Fattoresaimon/i2cencoder/RPi Demo/README.md

# I2C Encoder RPi Demo
--------------------------------------------------------------------------------

## Introduction

Here you can find a sample code written in C for the RPi.
With this code you can read up to 5 boards.
