Fattoresaimon/i2cencoder/Bottom_silk.jpg

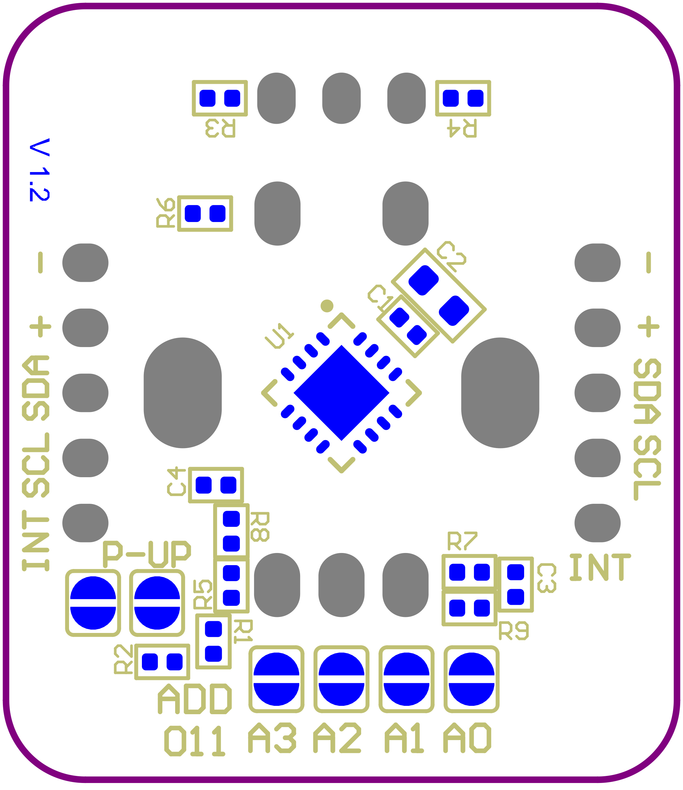
Bottom_silk.jpg
