Fattoresaimon/i2cencoder/ChainExample_Bot.jpg

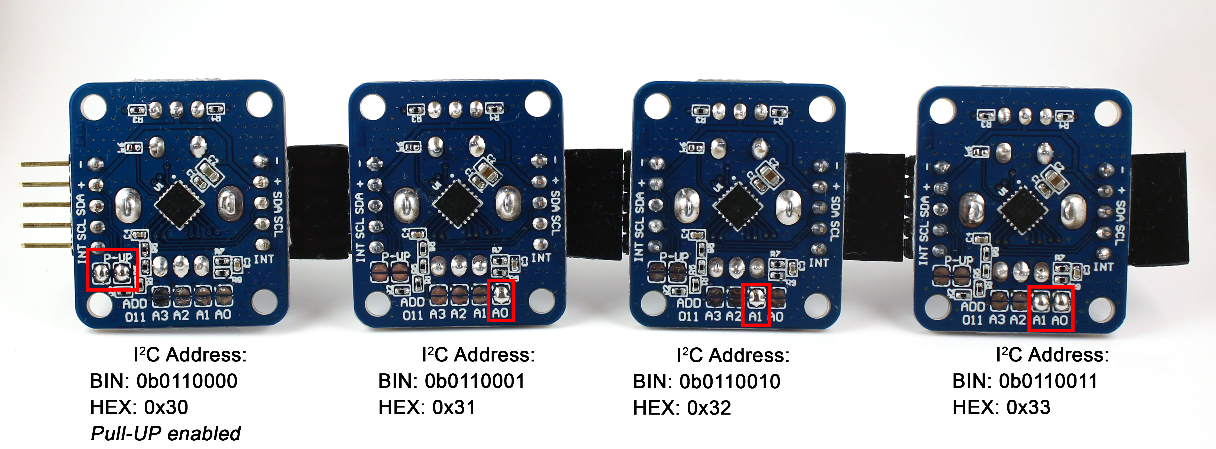
ChainExample_Bot.jpg
