Fattoresaimon/i2cencoder/Dimension.jpg

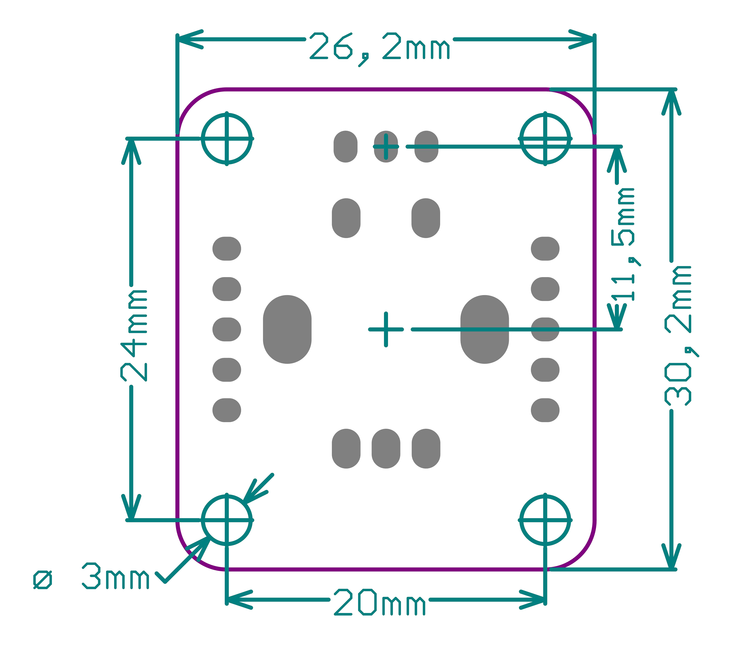
Dimension.jpg
