Fattoresaimon/i2cencoder/I2C Address Setting.PNG

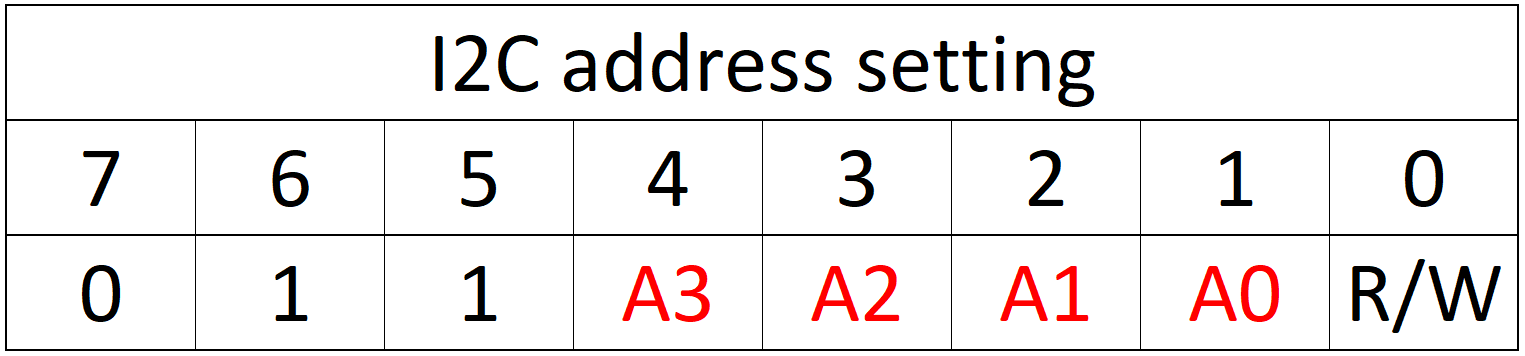
I2C Address Setting.PNG
