Fattoresaimon/i2cencoder/I2C_PullUP_Enable.jpg

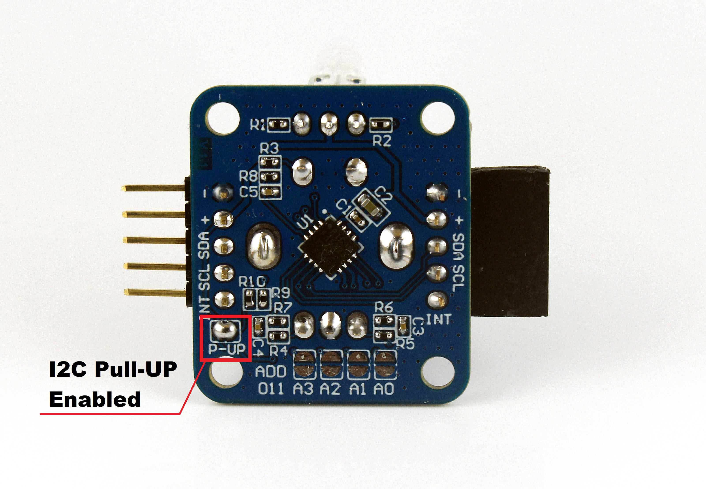
I2C_PullUP_Enable.jpg
