Fattoresaimon/i2cencoder/Pinout.jpg

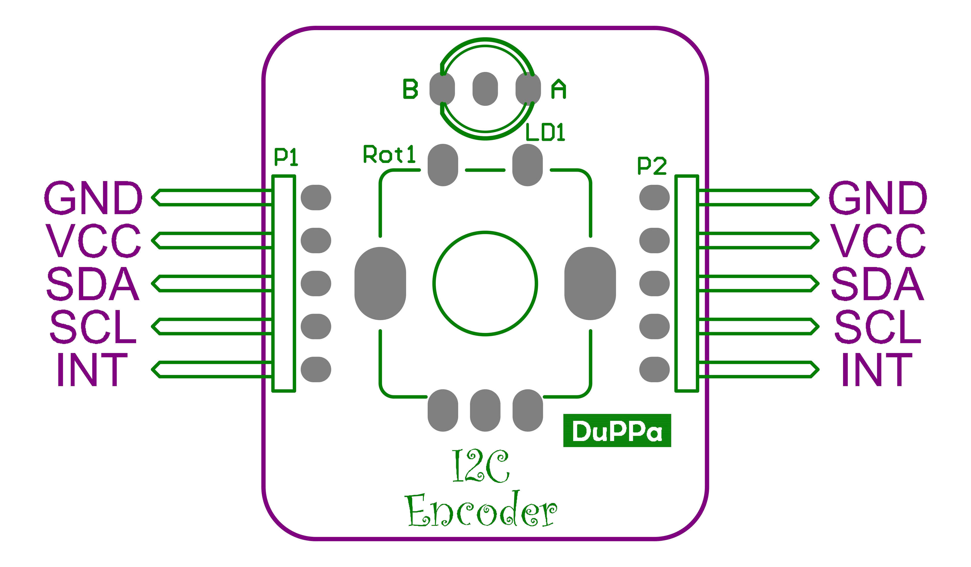
Pinout.jpg
