Fattoresaimon/i2cencoder/Hardware/EncoderI2C.xls

Description | Designator | Value | PartNumber | MouserCode | FarnellCode
Capacitor | C1 | 100n | GRM155R61C104KA88D | 81-GRM155R61C104KA8D
Capacitor | C2 | 4u7 | CC0603KRX5R7BB475 | 603-CC603KRX5R7BB475
Capacitor | C3 | 10n | GRM155R71H103KA88D | 81-GRM155R71H103KA8D
Capacitor | C4 | 10n | GRM155R71H103KA88D | 81-GRM155R71H103KA8D
Common Anode bi-color LED | LD1
Header, 5-Pin, Right Angle Male | P1 |  | 22-28-8050 | 538-22-28-8050
Header, 5-Pin, Right Angle Female | P2 |  | BG302-05-A-L-G |  | 2084275
Resistor | R1 | 4k7 | ERJ-2GEJ4R7X | 667-ERJ-2GEJ4R7X
Resistor | R2 | 4k7 | ERJ-2GEJ4R7X | 667-ERJ-2GEJ4R7X
Resistor | R3 | 110r | ERJ-2GEJ111X | 667-ERJ-2GEJ111X
Resistor | R4 | 110r | ERJ-2GEJ111X | 667-ERJ-2GEJ111X
Resistor | R5 | 10k | RC0402FR-0710KL | 603-RC0402FR-0710KL
Resistor | R6 | 10k | RC0402FR-0710KL | 603-RC0402FR-0710KL
Resistor | R7 | 10k | RC0402FR-0710KL | 603-RC0402FR-0710KL
Resistor | R8 | 10k | RC0402FR-0710KL | 603-RC0402FR-0710KL
Rotary Encoder | Rot1
SMD Jumper | SJ1
SMD Jumper | SJ2
SMD Jumper | SJ3
SMD Jumper | SJ4
SMD Jumper | SJ5
SMD Jumper | SJ6
Flash, 8-Bit Microcontroller, 20 MHz, 11 I/O, -40 to 125 degC, 16-pin QFN (MG16), Tube | U1 |  | PIC16F15323-I/JQ | 579-PIC16F15323-I/JQ
