Fattoresaimon/i2cencoder/(threads)

Thread 2 (2018-07-19):

Encoder button pushed?

MoonMoon82, 2018-07-19:
Hi! I just started working with the i2c rotary encoder.
The first question is: How can I determin if the pushbutton is (still) pressed and released?

Thx and kind regards

MoonMoon82, 2018-07-20:
Thanks for your answer!
I reviewed the schematic and connected a GPIO of my arduino to the pushbutton pin (see picture below).
Now I can use readStatus(E_PUSH) as a filtered trigger from the FW and listen to the GPIO to get the state.
It's a bit disappointing that there's no other way to recognise the state of the pushputton.

Kind regards
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

MoonMoon82, 2018-07-20:
Hi,

I would love to, but I have no experience in programming PICs in MPLAB X IDE.
I‘m just happy to be able to program Arduinos and ESPs in plattform.io. And I have no experience in JTAG programmer, if this is what‘s needed.. I‘m sorry to be a noob -.-

gorbounov, 2020-09-01:
Hi,
It seems like the drill file is missing in Gerber for EncoderI2Cv1.2. Could you upload it?

Thread 3 (2020-09-01):

drill file for EncoderI2Cv1.2

gorbounov, 2020-09-01:
Hi,
It seems like the drill file is missing in Gerber for EncoderI2Cv1.2. Could you upload it?

Fattoresaimon, 2020-09-01:
Hello,
They are in the folder NC drill:
https://github.com/Fattoresaimon/I2CEncoderV2.1/tree/master/Hardware/NC%20Drill

Thread 4 (2022-08-28):

Interrupt signal stucked pulled low after I2C reading

AdriGuillaume, 2022-08-28:
Hello,

I'm facing to an issue that I can success to solve.

I have 5 encoders wired on a Nano Every. I success to init the 5 encoders and
all the 5 encoders work well, when they are read in loop for test.

The Interrupt signal of encoders is wired on input pull up pin of nano every.
an interrupt vector is assigned to this pin.
In my main loop, I have a "state machin" where the state is drove by the interrupt subroutine.

So state machin is in IDLE mode until encoder pull down signal interrupt and then jump to ENCODER_EVENT to reading all the 5 encoders register (one after one).
after reading, state machin come back to IDLE mode until next encoder interrupt.

problem :

it happen that interrupt signal from encoder get stuck pulled low at the end of reading. I generaly happen when I turn rapidly encoder, (it happens too with push bouton when I spam it). The consequence is that my state machin go back to IDLE mode but no more interrupt signal from encoder can be detected because interrupt signal is dead stucked low... and than I cannot read anymore encoders status...

I think it come from an interference between gpio interrupt (high priority) and I2C interrupt (low priority)... so maybe something like encoder never receive ACK or something else and stay stucked in transmission mode. but i'm not really sure of it...

maybe do you have an idea ?

Thanks !
BR
Adrien

Fattoresaimon, 2022-08-28:
Hello,
If the interrupt get stuck low it means you didn't read the encoder status register.
Here the code inside the I2C encoder:
```
case REG_ESTATUS:
  return_value = ESTATUS;
  ESTATUS = 0;
  INT_SetHigh();
  break;
```
You should try to read the encoders until the interrupt return high.
Probably when you rotate the encoder faster your code read the first interrupt, but after that another one might occur because your are still rotating and you miss that.

I have tested with 9 encoders and with multiple type of board but no issue with that point. I even teste with 1MHz I2C clock :)

Thank you!

AdriGuillaume, 2022-08-29:
Hello,

Thanks for your help and your reply ;)
yes it's what I was thinking at the beginning before interrupt INT0/I2C priority.

ok so I have make a "do while" loop condition and read encoder interrupt pin while it's low...

it seems to works now !

thanks

BR
Adrien
