Fattoresaimon/i2cencoder/Hardware/EncoderI2C.pdf

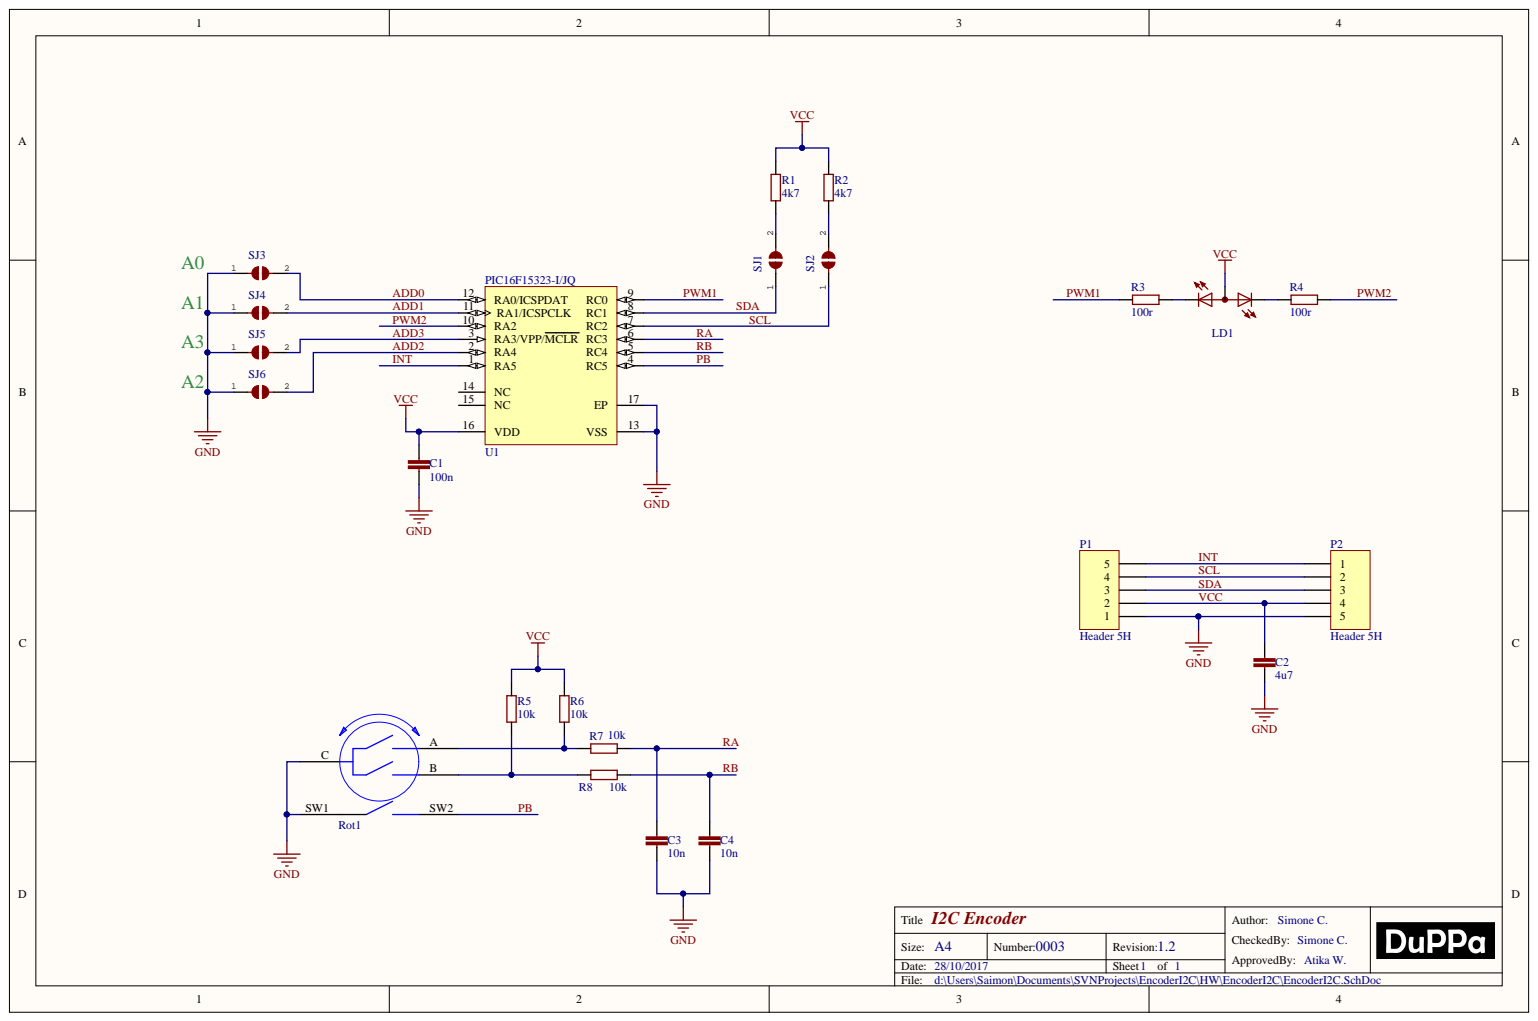
[picture p22: page 1]

I2C Encoder Title | Author: Simone C. CheckedBy: Simone C. ApprovedBy: Atika W.

Size: A4 | Number: 0003 | Revision: 1.2
Date: 28/10/2017 | | Sheet 1 of 1

d:\Users\Saimon\Documents\SVNProjects\EncoderI2C\HW\EncoderI2C\EncoderI2C.SchDoc

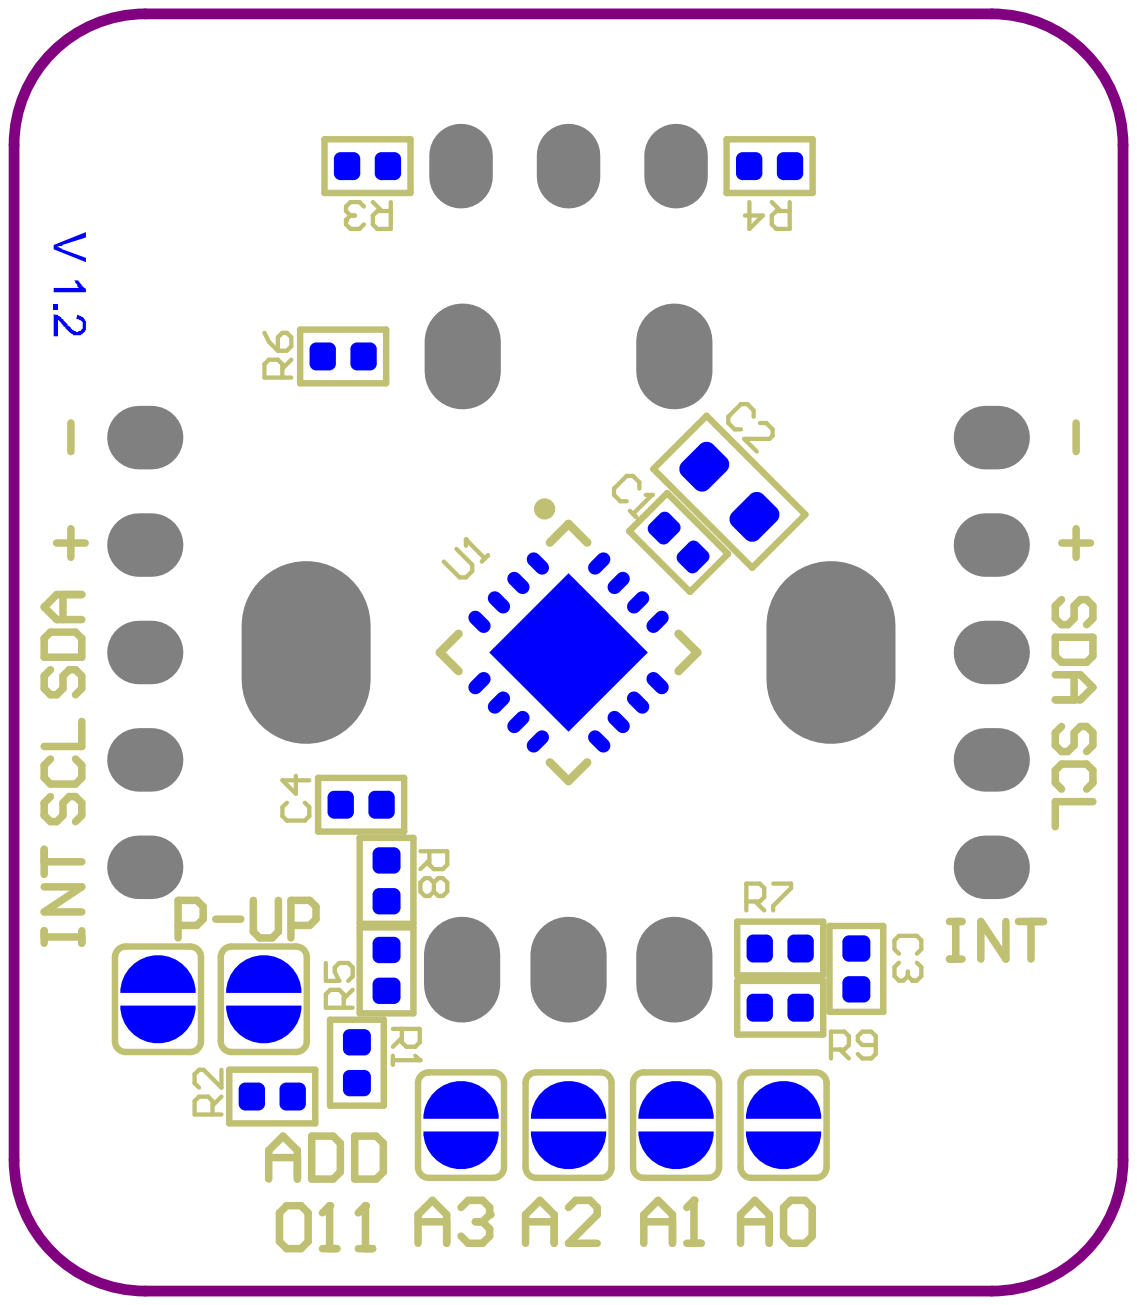
[picture p23: page 2]

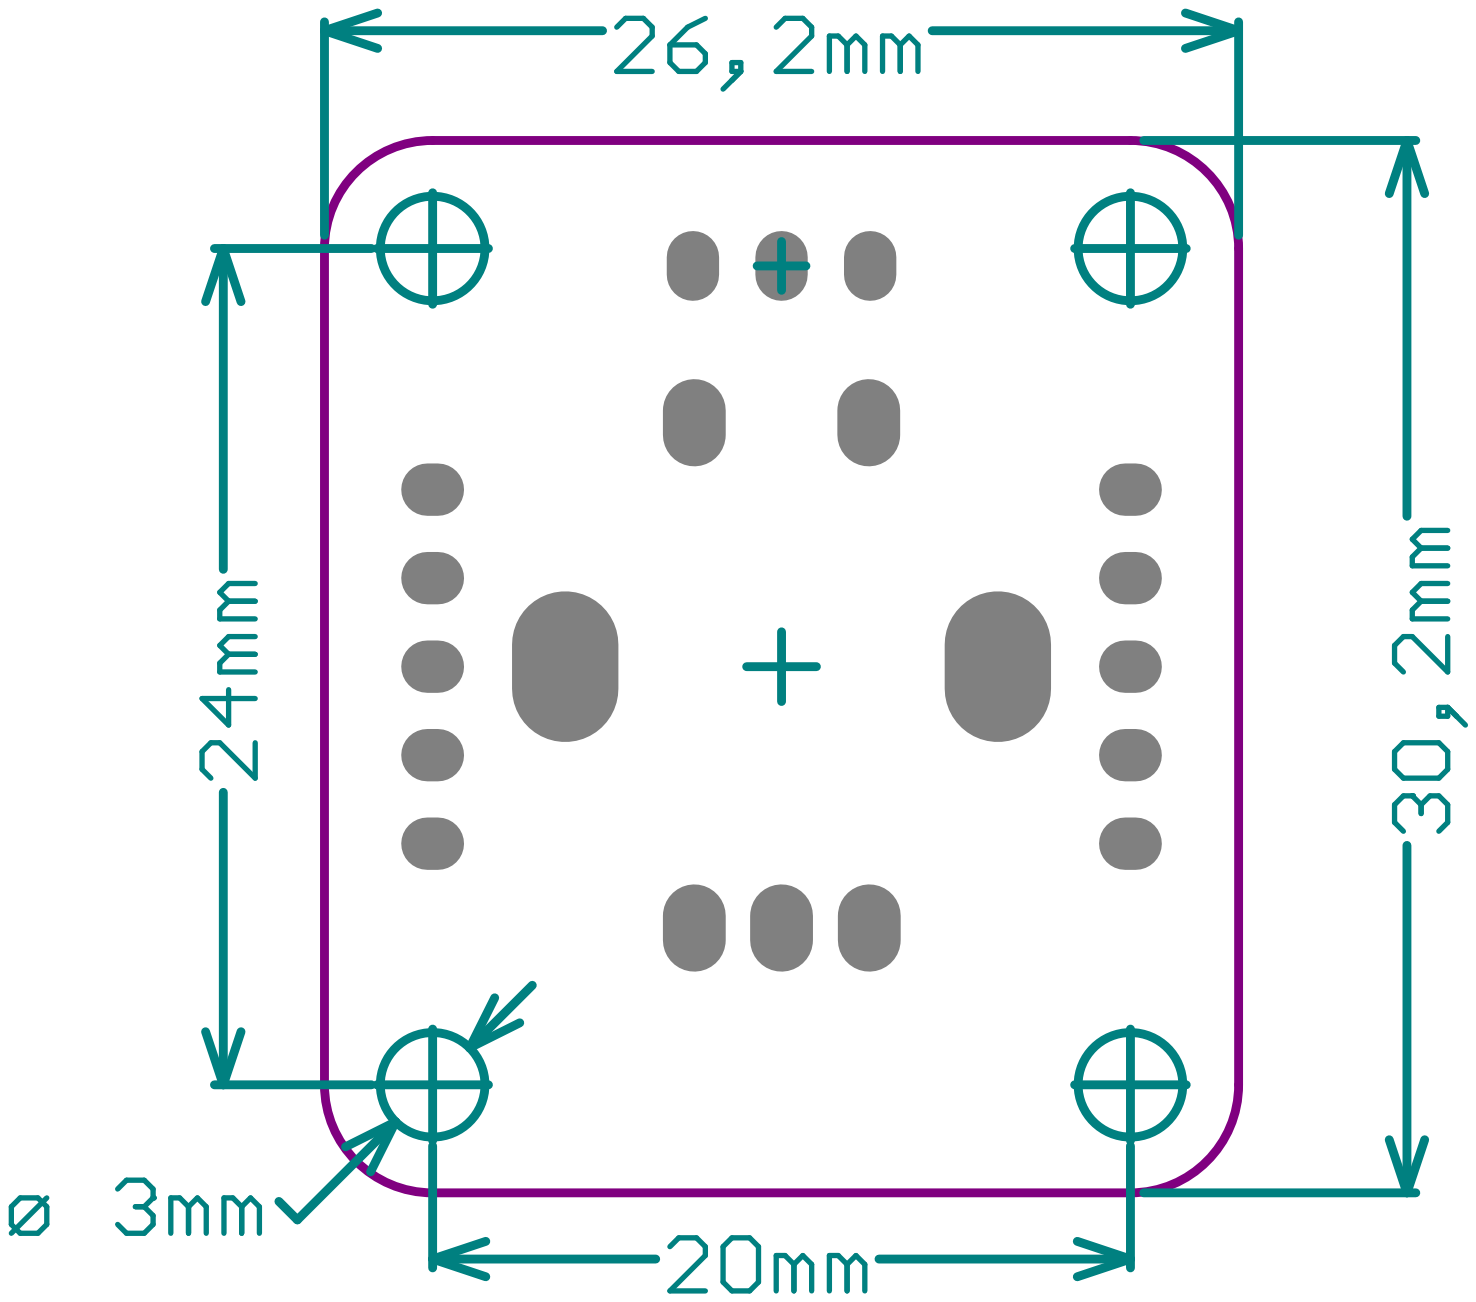
[picture p24: page 3]

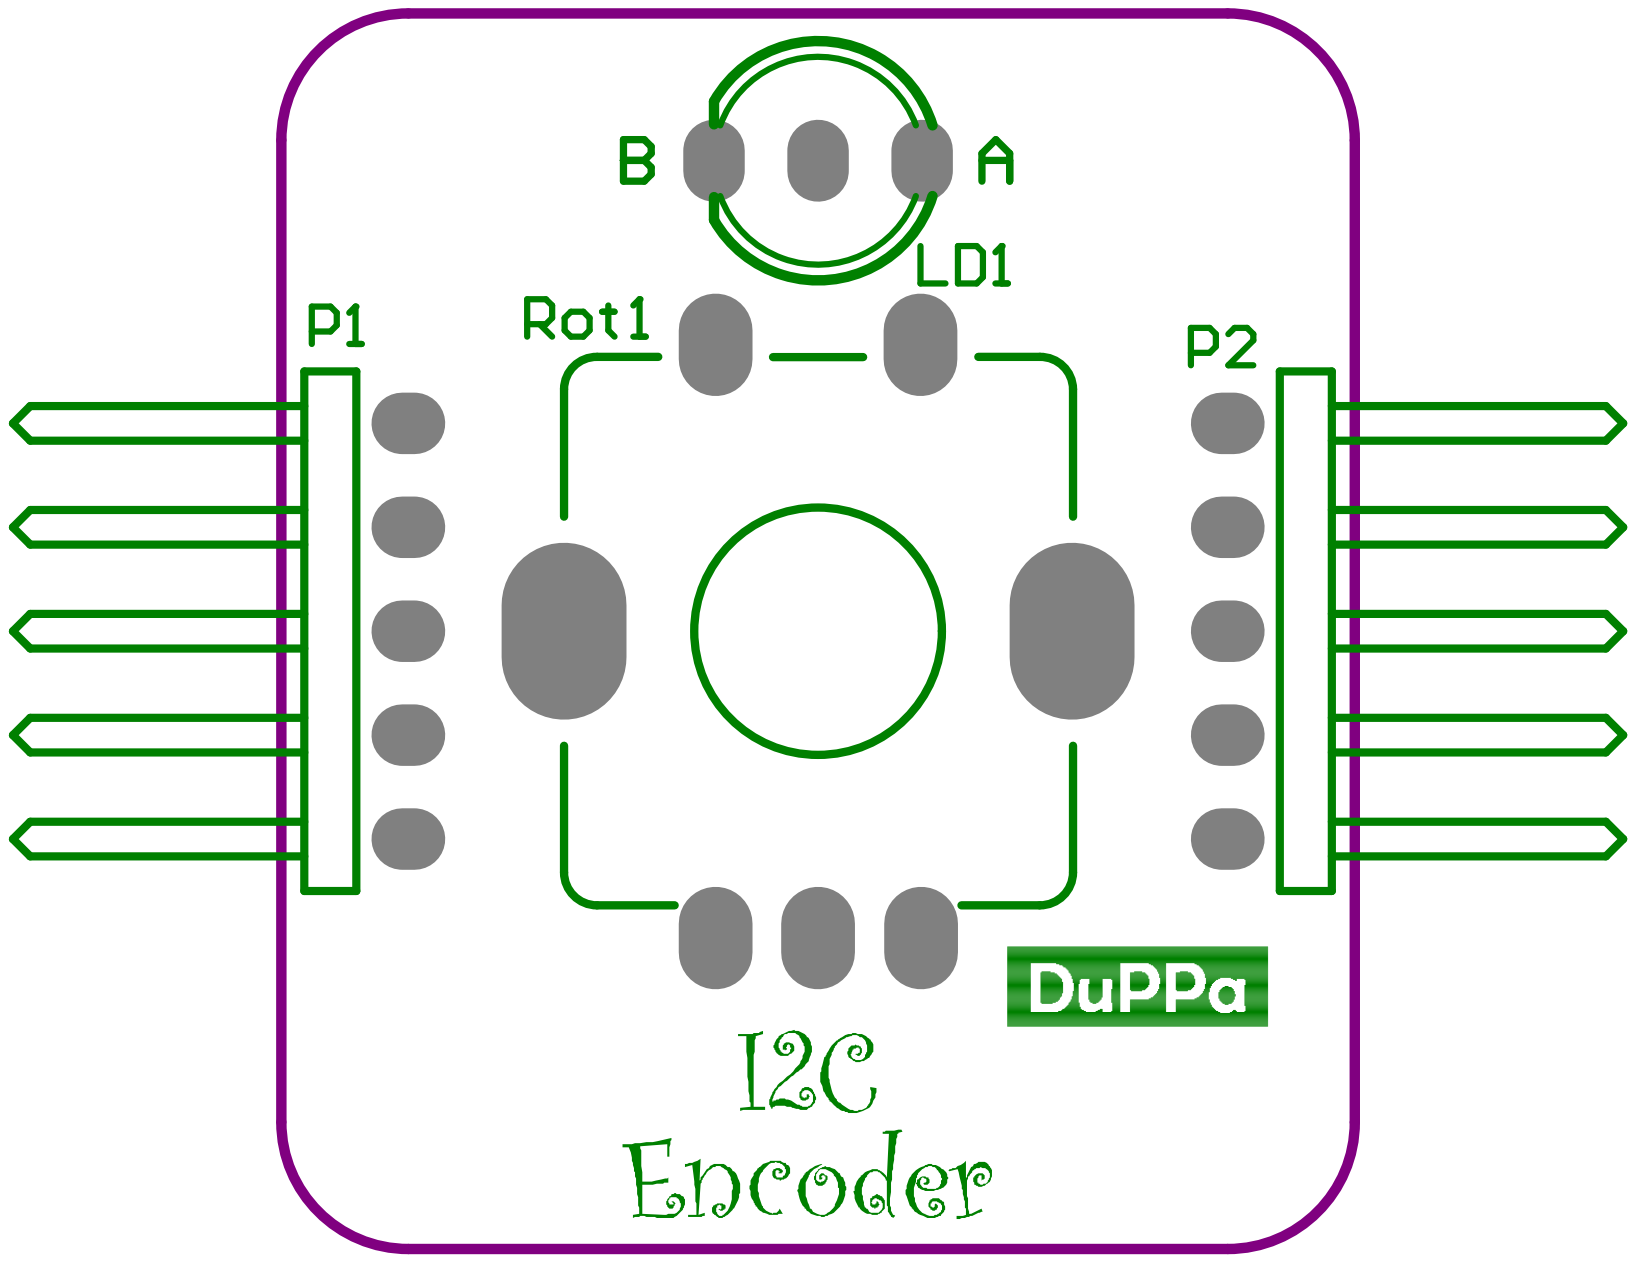
[picture p25: page 4]

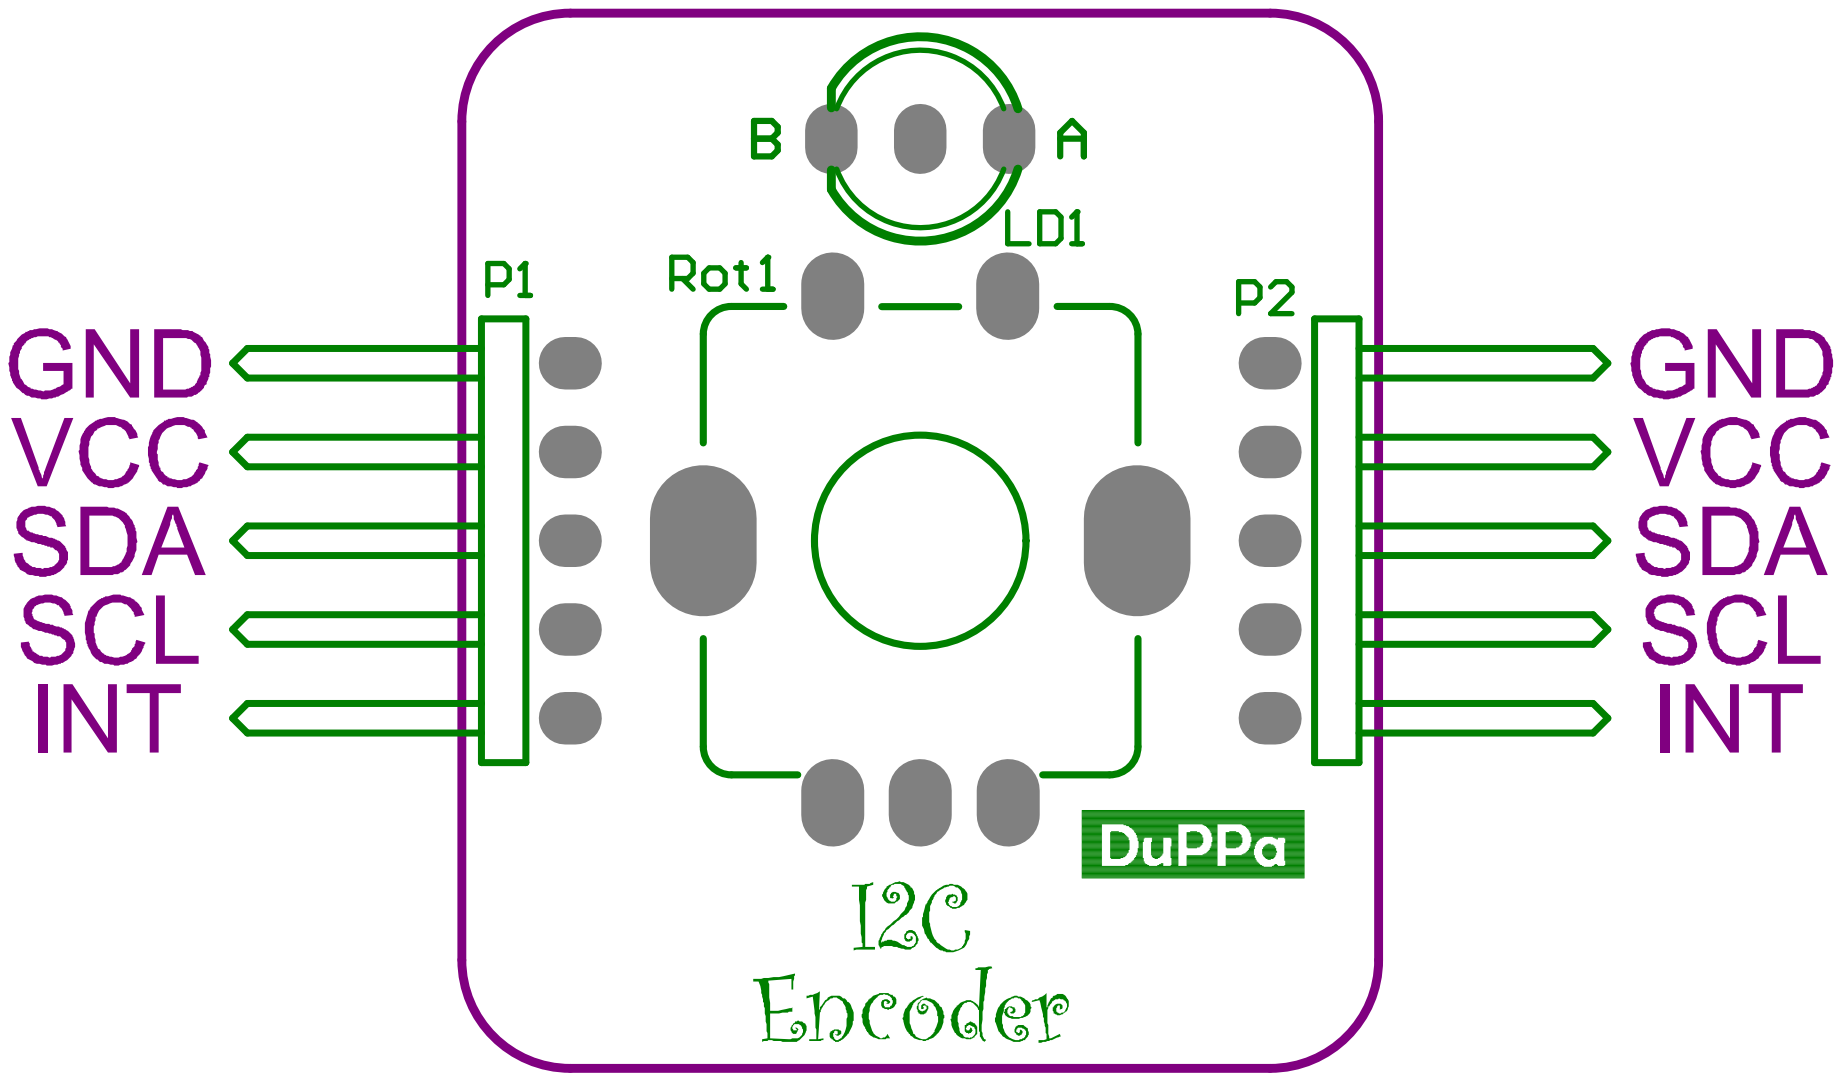
[picture p26: page 5]
