Fattoresaimon/i2cencoder/(commit log)

2017-10-10 First commit of the project
    [BOM_EncoderI2C.xls]
2017-10-17 FW bug fix
    FW bug fix about the counter value when the threshold are set
    [i2c_register.c]
2017-10-17 First version of the Arduino library description
2017-10-18 Fixed README in arduino library
2017-10-20 New Arduino example
2017-10-22 i2c pull-up resistor workaround
2017-11-22 Added HW v1.2
    HW v1.2
    I2C issue resolved
    [BOM_EncoderI2C.xls, EncoderI2C.xls]
